willipe53/jolida/docs/Jolida-JD202A-int-sch.pdf

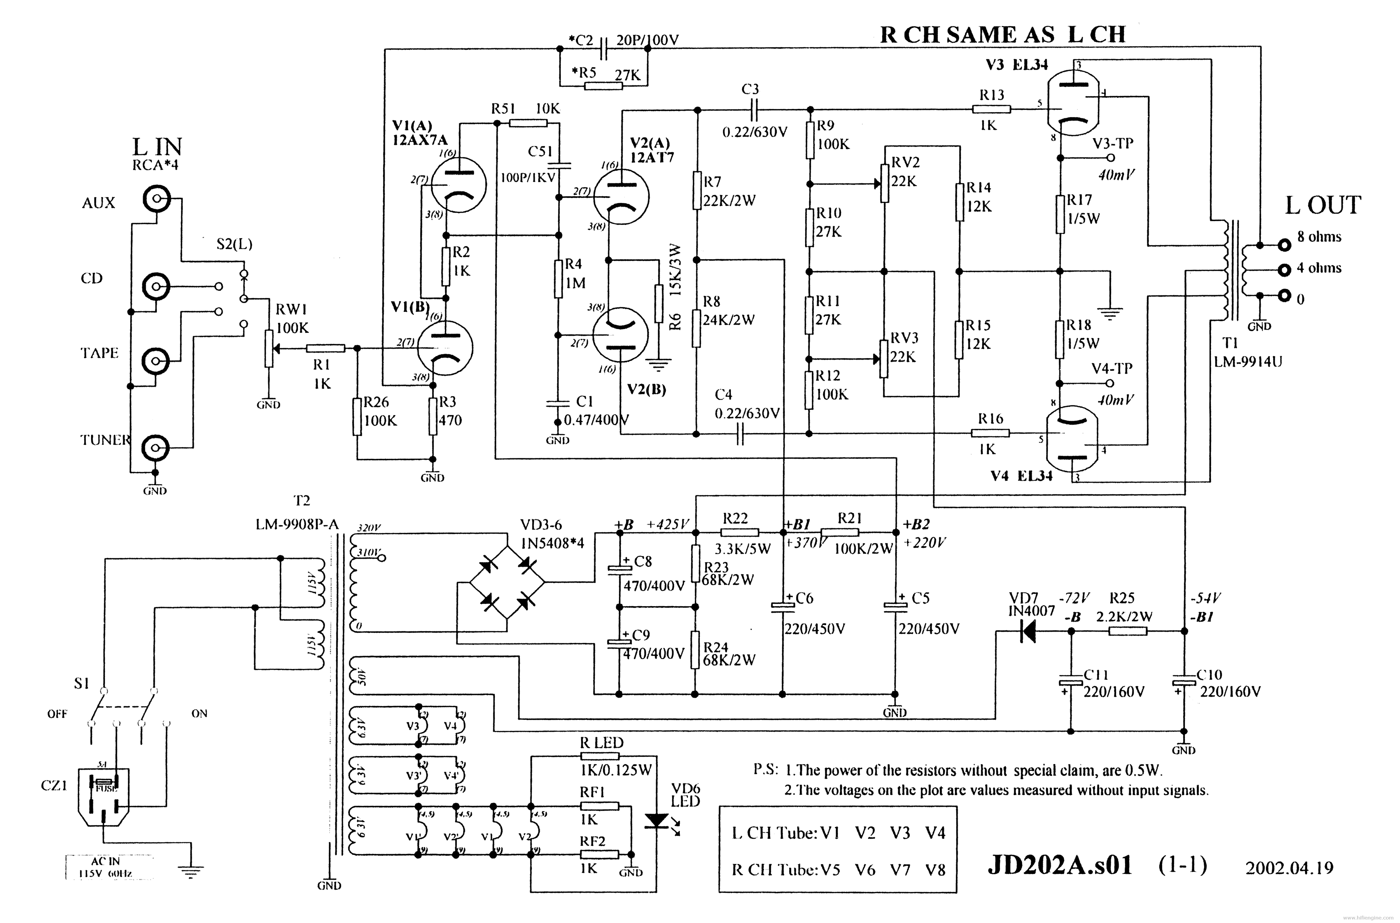
[picture p8: page 1]
