willipe53/jolida/docs/_sch-output.png

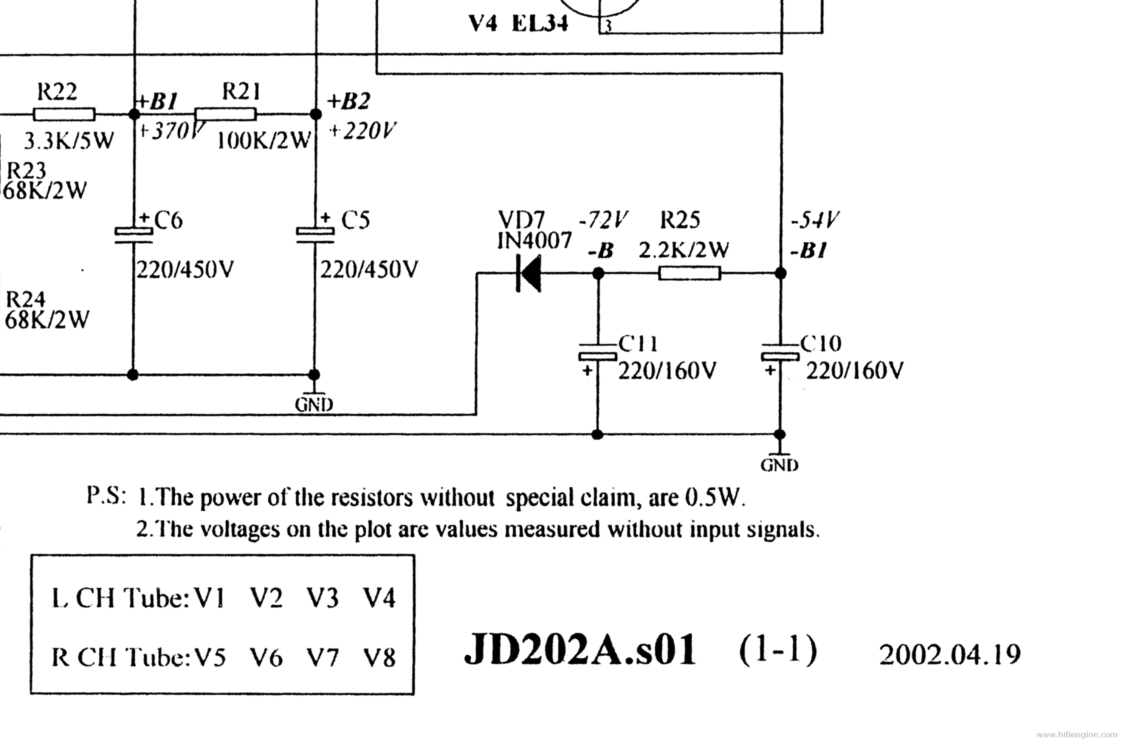
docs/_sch-output.png
