willipe53/jolida/docs/_sch-power.png

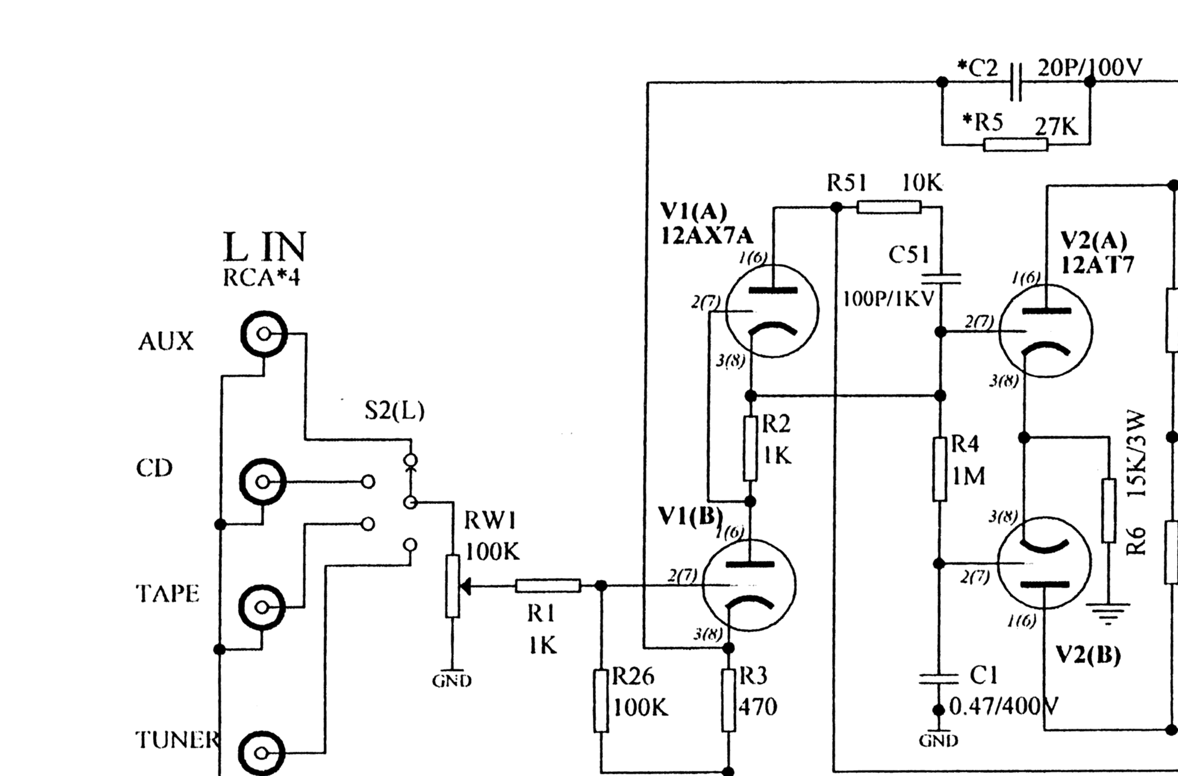
docs/_sch-power.png
