willipe53/jolida/docs/_sch-preamp.png

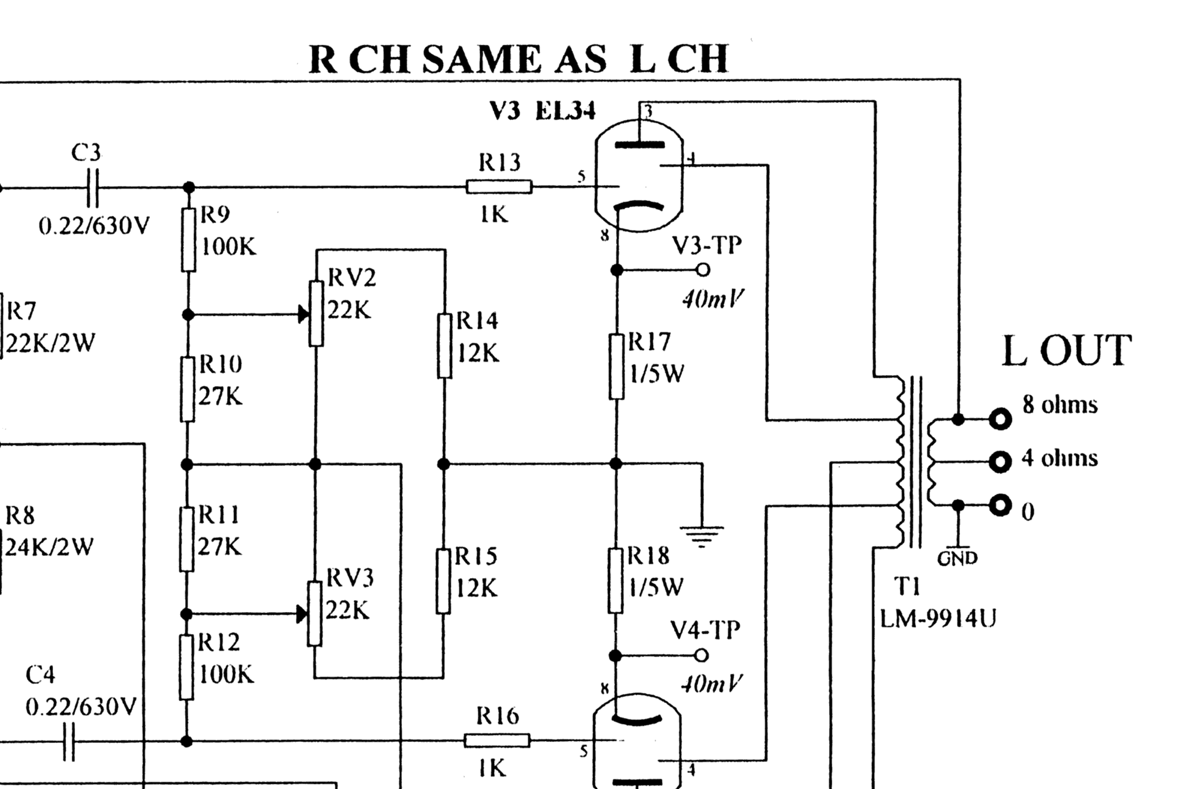
docs/_sch-preamp.png
