willipe53/jolida/docs/_sch-psu-detail.png

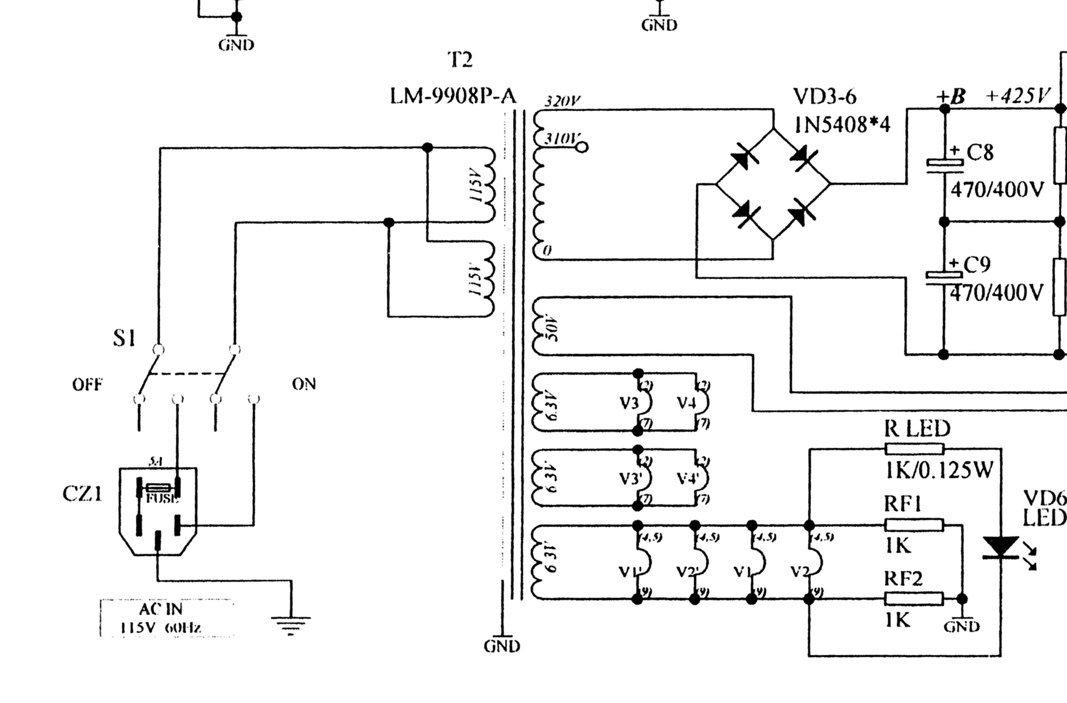
docs/_sch-psu-detail.png
