willipe53/jolida/docs/power-board.png

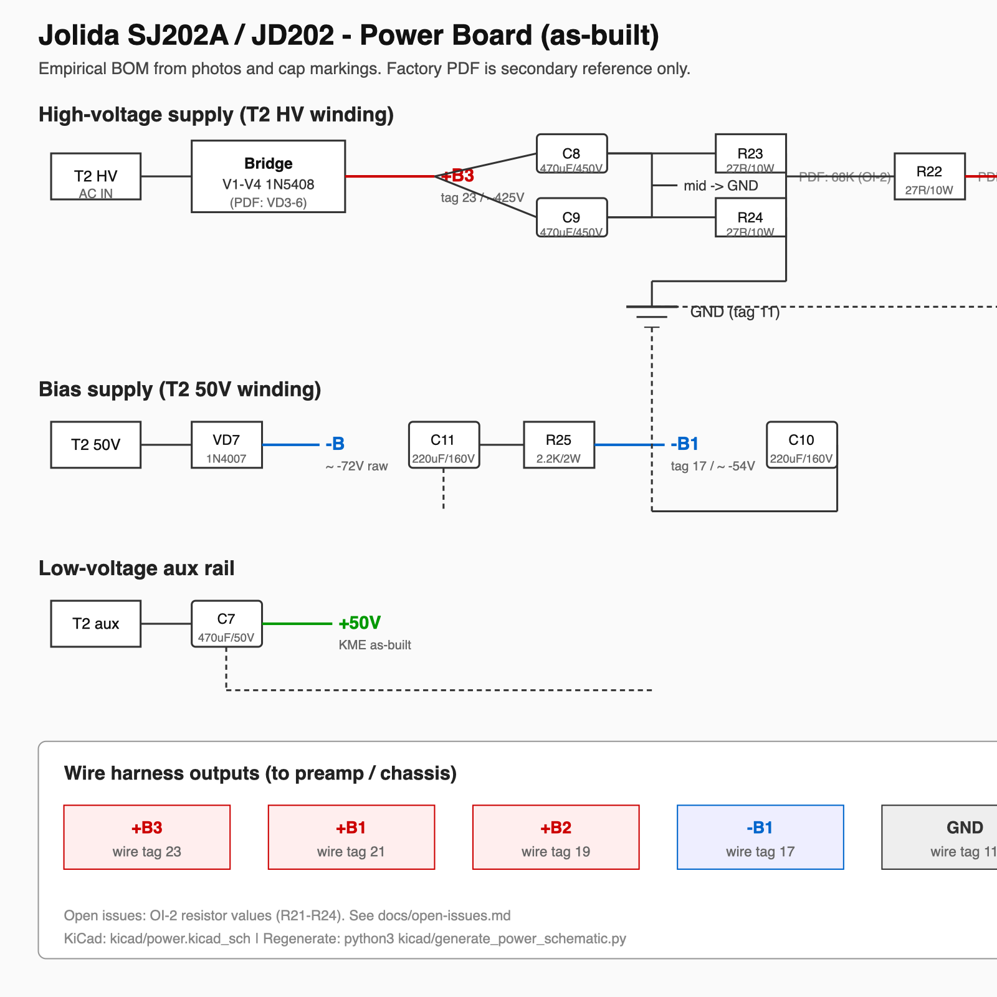
docs/power-board.png
