willipe53/jolida/photos/8 pin 1.png

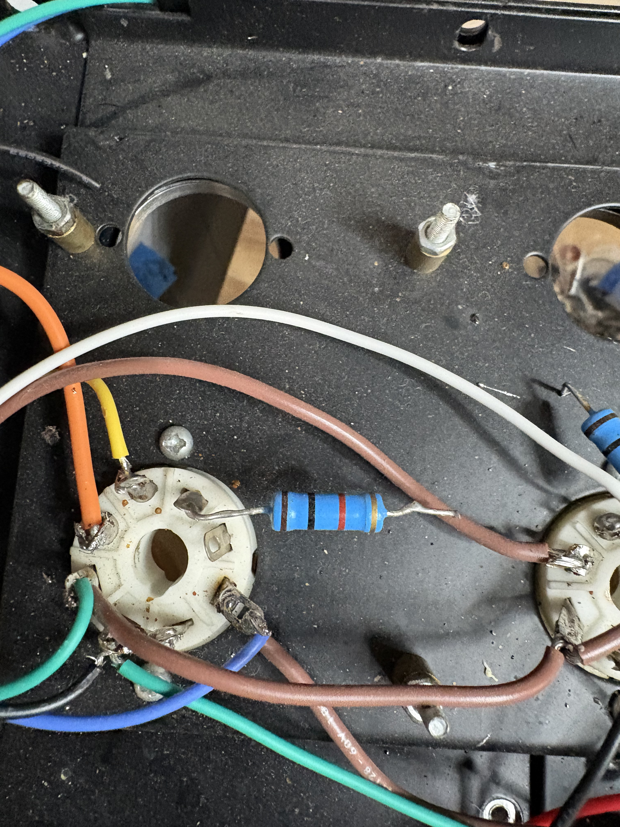
photos/8 pin 1.png
