willipe53/jolida/photos/8 pin 3.png

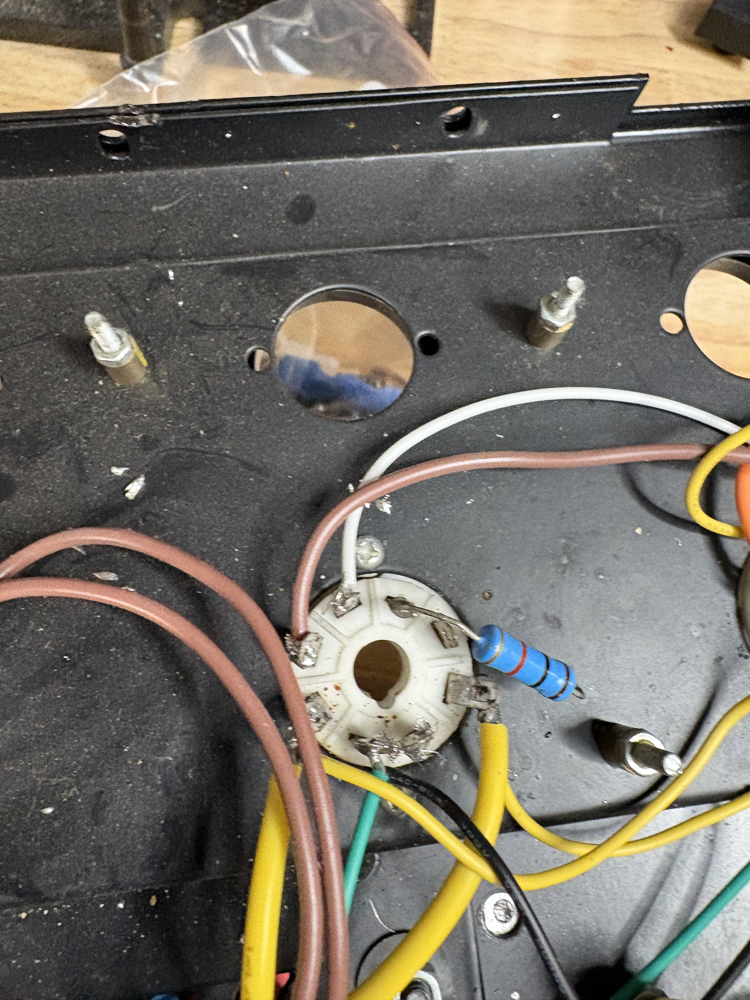
photos/8 pin 3.png
