willipe53/jolida/photos/8 pin 4.png

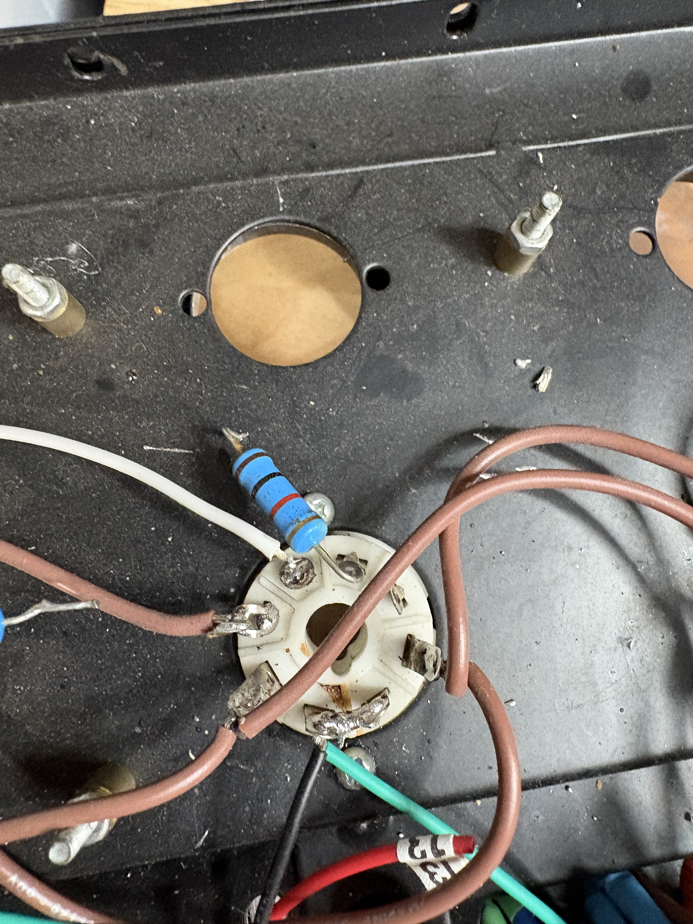
photos/8 pin 4.png
