willipe53/jolida/photos/8 pin 5.png

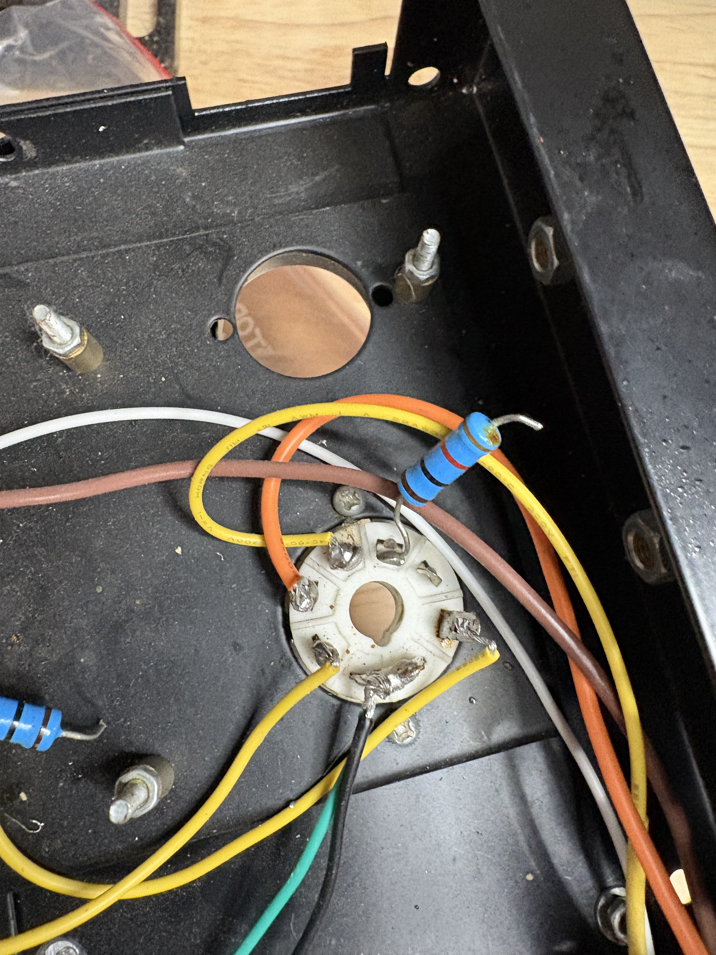
photos/8 pin 5.png
