willipe53/jolida/photos/feet.png

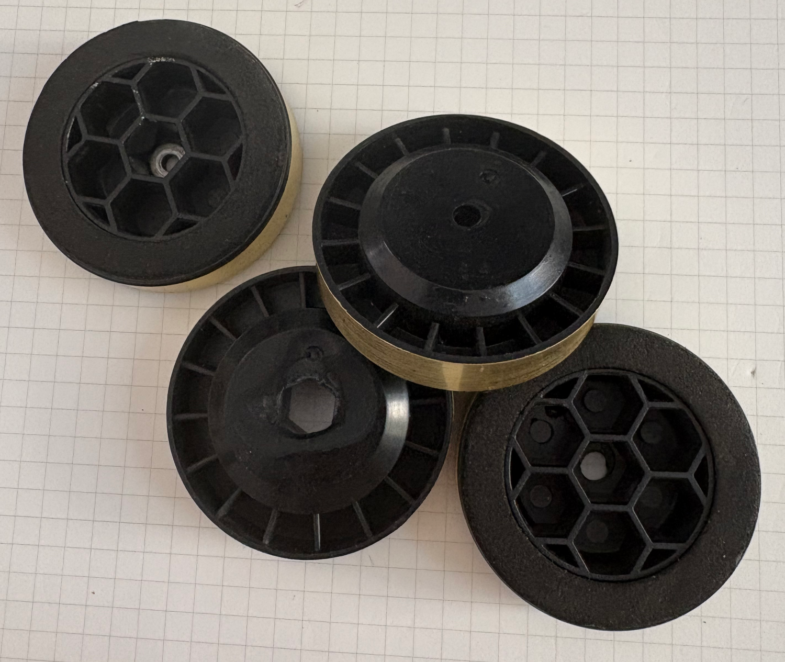
photos/feet.png
