willipe53/jolida/photos/fuse dry fit.png

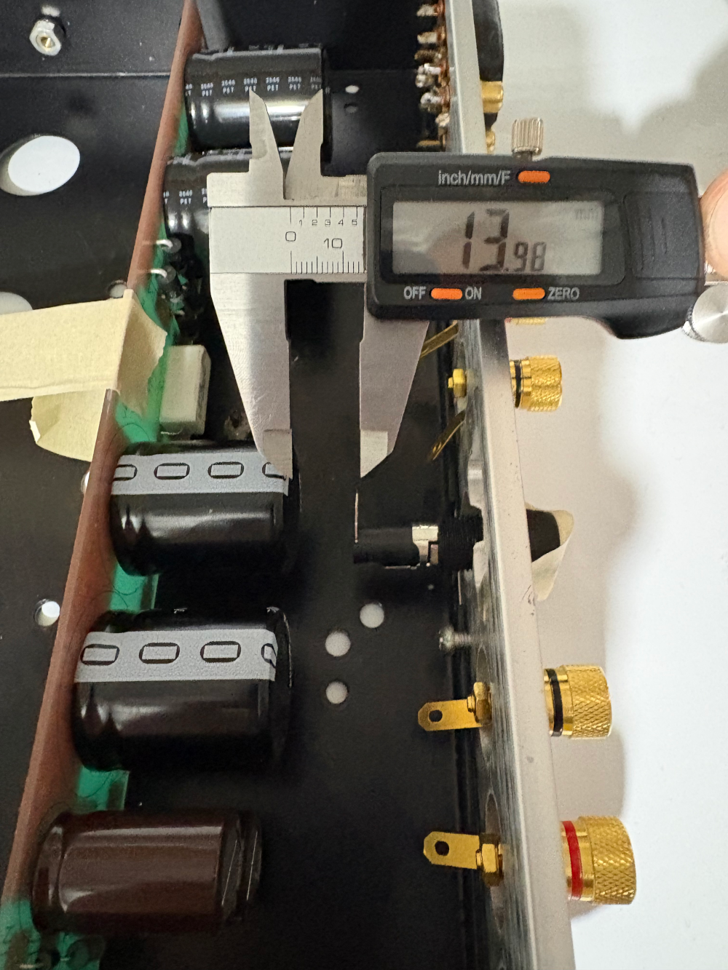
photos/fuse dry fit.png
