willipe53/jolida/photos/green caps.png

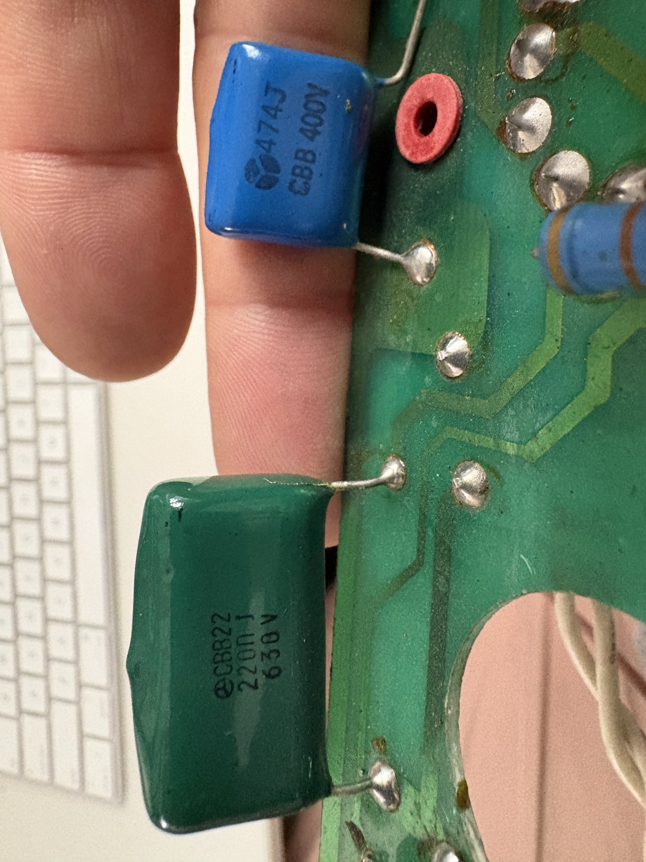
photos/green caps.png
