willipe53/jolida/photos/irl244n.png

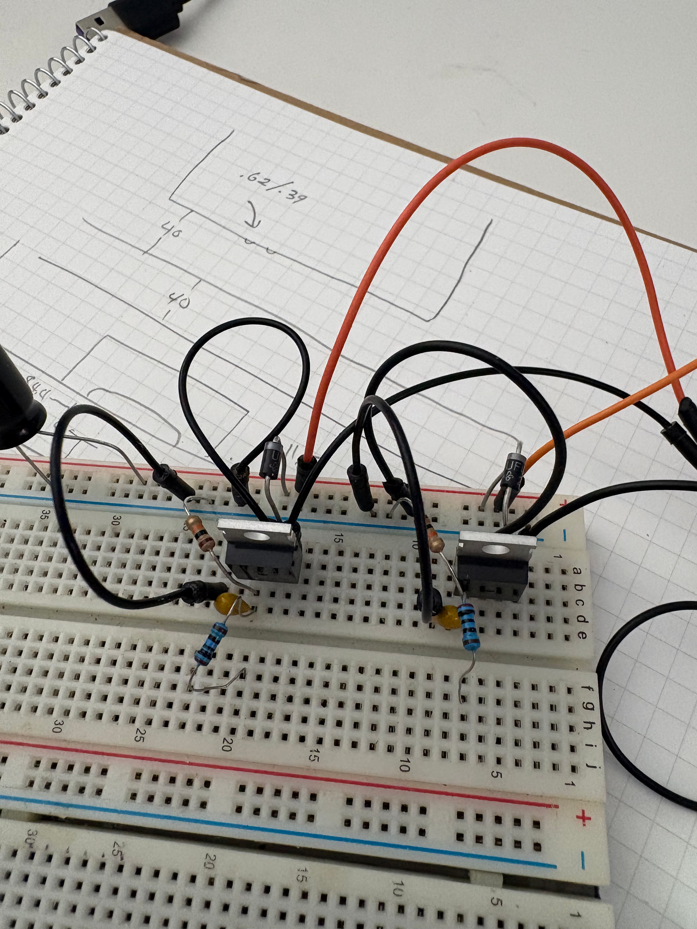
photos/irl244n.png
