willipe53/jolida/photos/LED wires.png

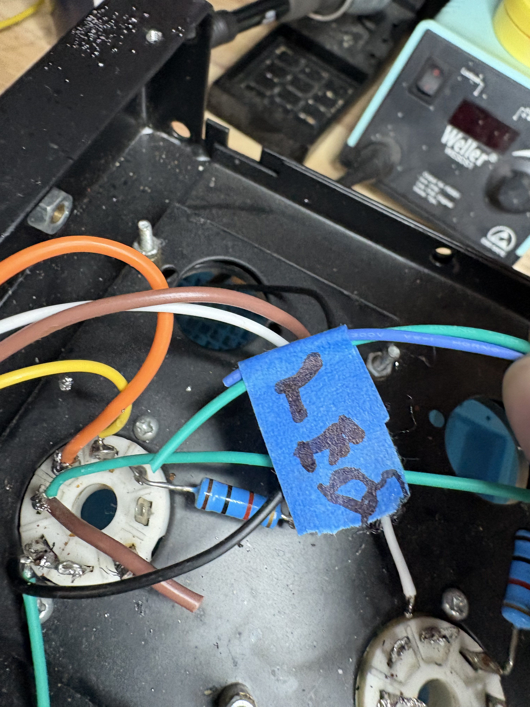
photos/LED wires.png
