willipe53/jolida/photos/preamp board top center.png

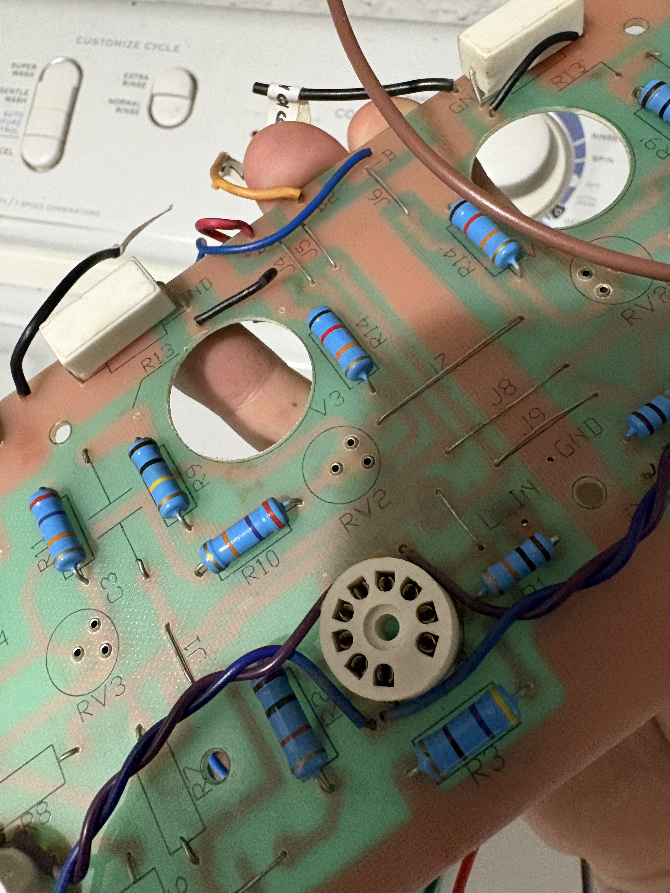
photos/preamp board top center.png
