willipe53/jolida/photos/speaker_posts.png

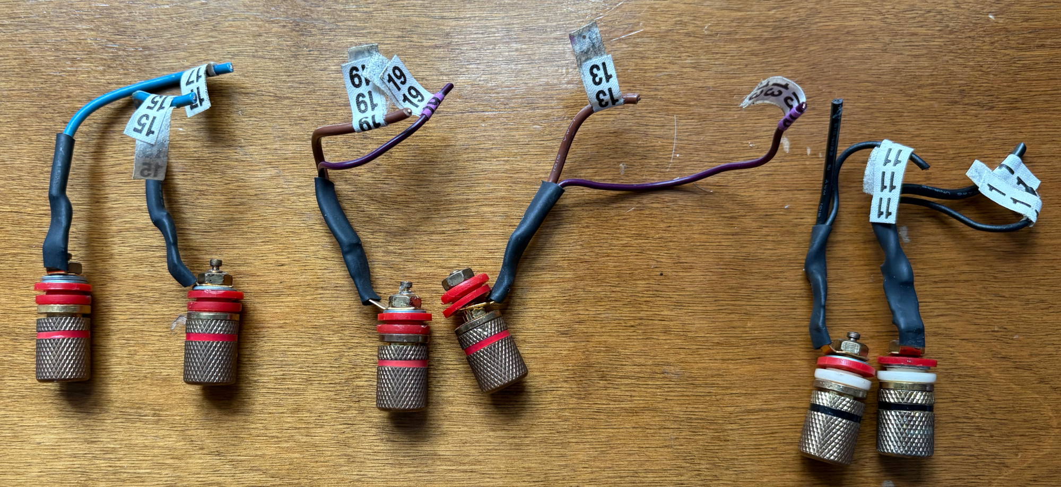
photos/speaker_posts.png
