willipe53/jolida/photos/trim pots.png

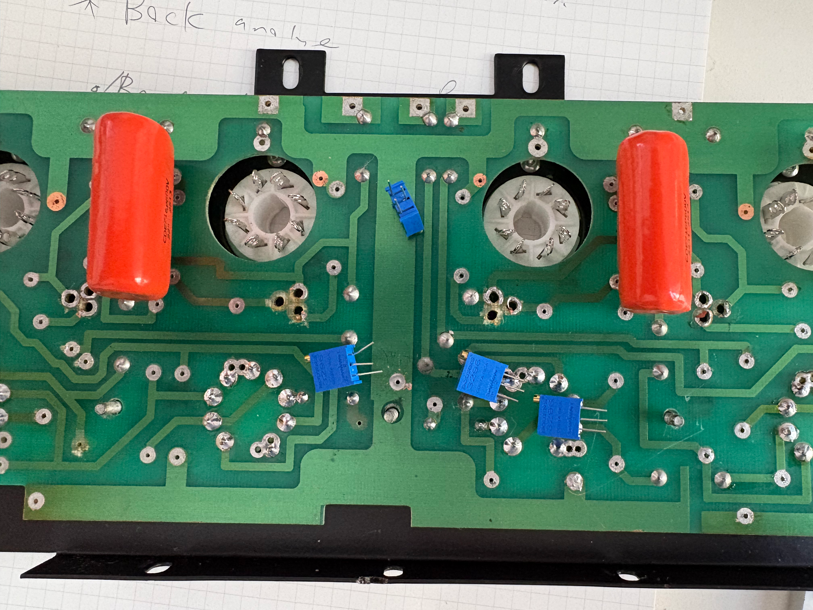
photos/trim pots.png
