willipe53/jolida/photos/tube layout.png

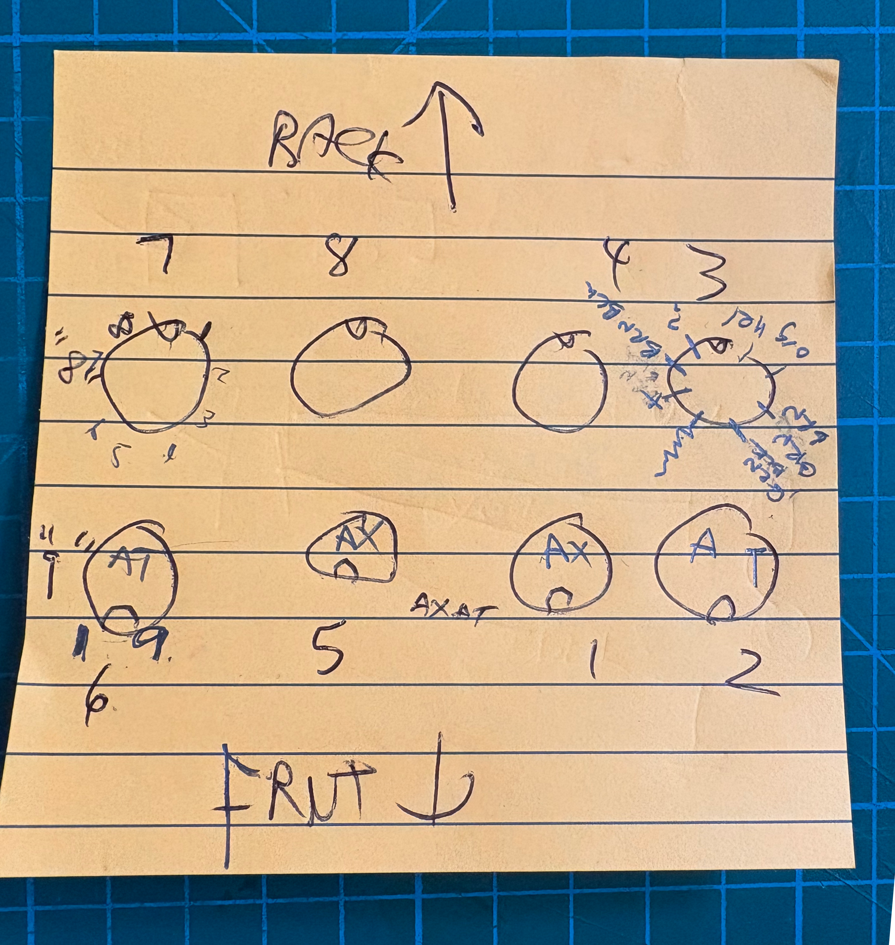
photos/tube layout.png
