willipe53/jolida/3d_printing/color_ring.3mf

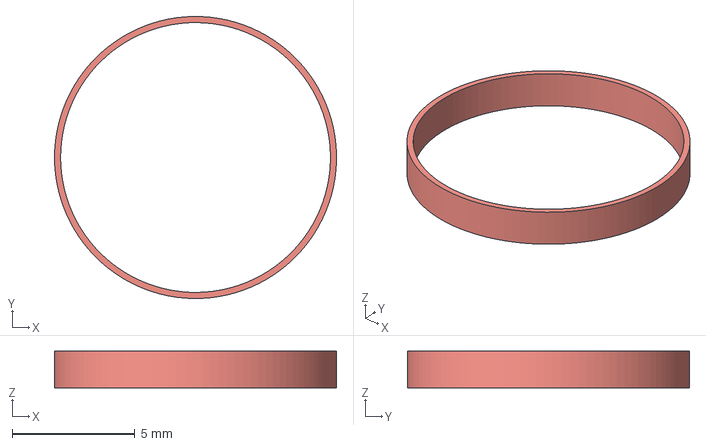
[picture p36: CAD file, 2026-07-29]
3d_printing/color_ring.3mf
11.5 x 11.5 x 1.50 mm
