willipe53/jolida/3d_printing/aux_only.3mf

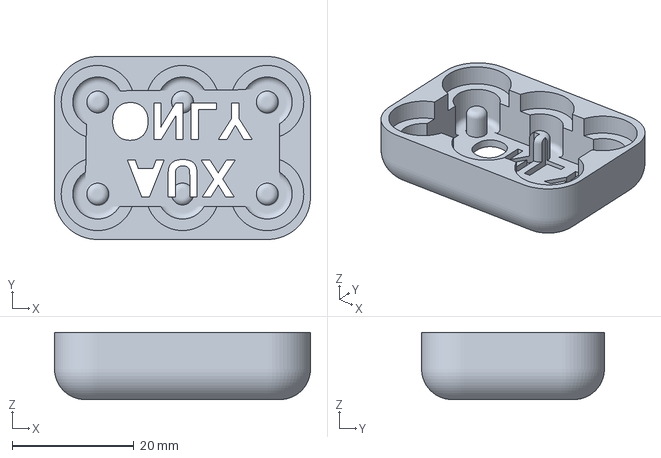
[picture p37: CAD file, 2026-07-29]
3d_printing/aux_only.3mf
42.0 x 30.0 x 11.0 mm
