willipe53/jolida/3d_printing/spkrspace.3mf

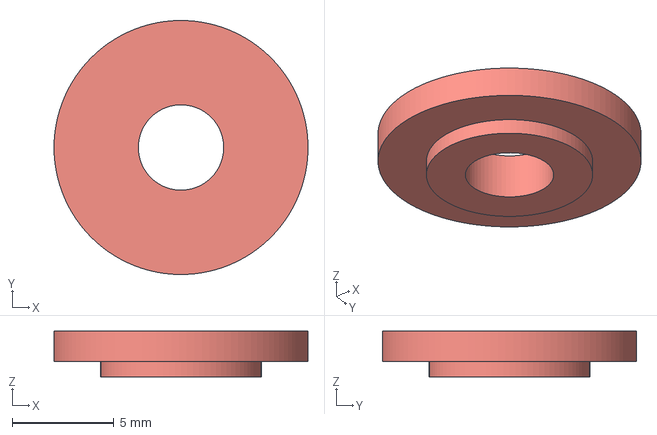
[picture p38: CAD file, 2026-07-29]
3d_printing/spkrspace.3mf
12.5 x 12.5 x 2.25 mm
