willipe53/jolida/photos/assembled amp.png

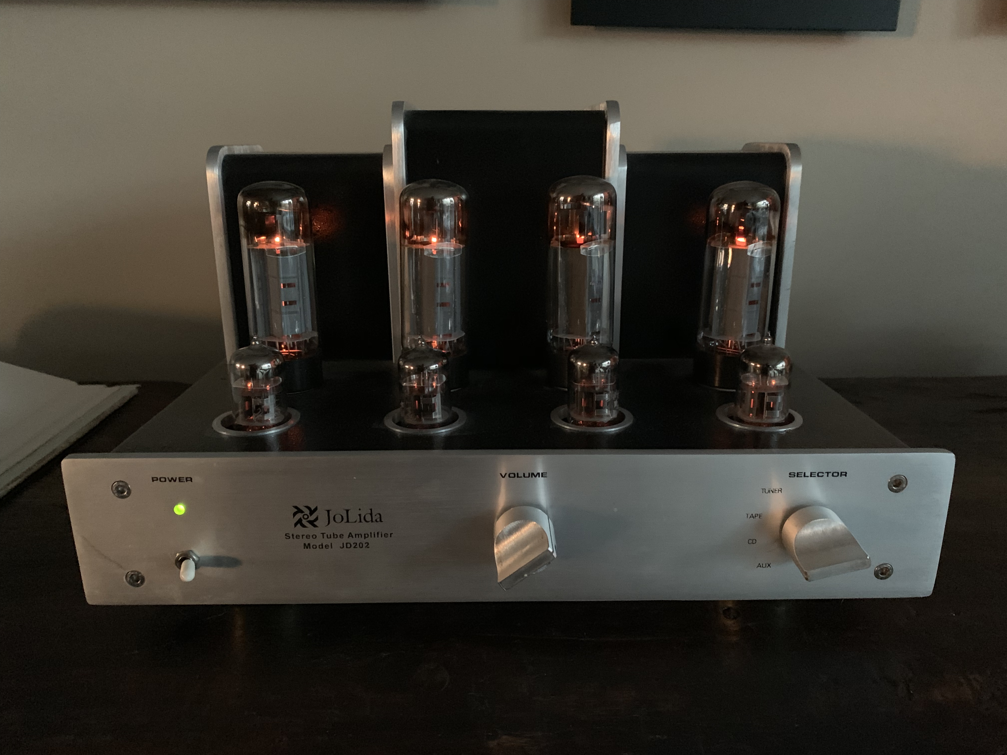
photos/assembled amp.png
