willipe53/jolida/photos/assembled bottom.png

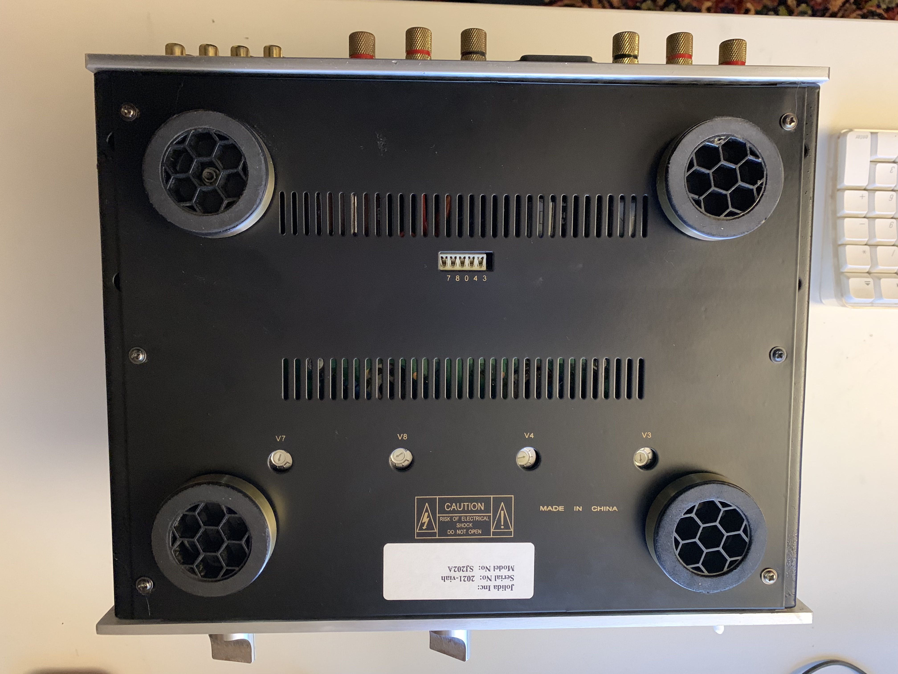
photos/assembled bottom.png
