willipe53/jolida/photos/preamp board bottom before desolder.png

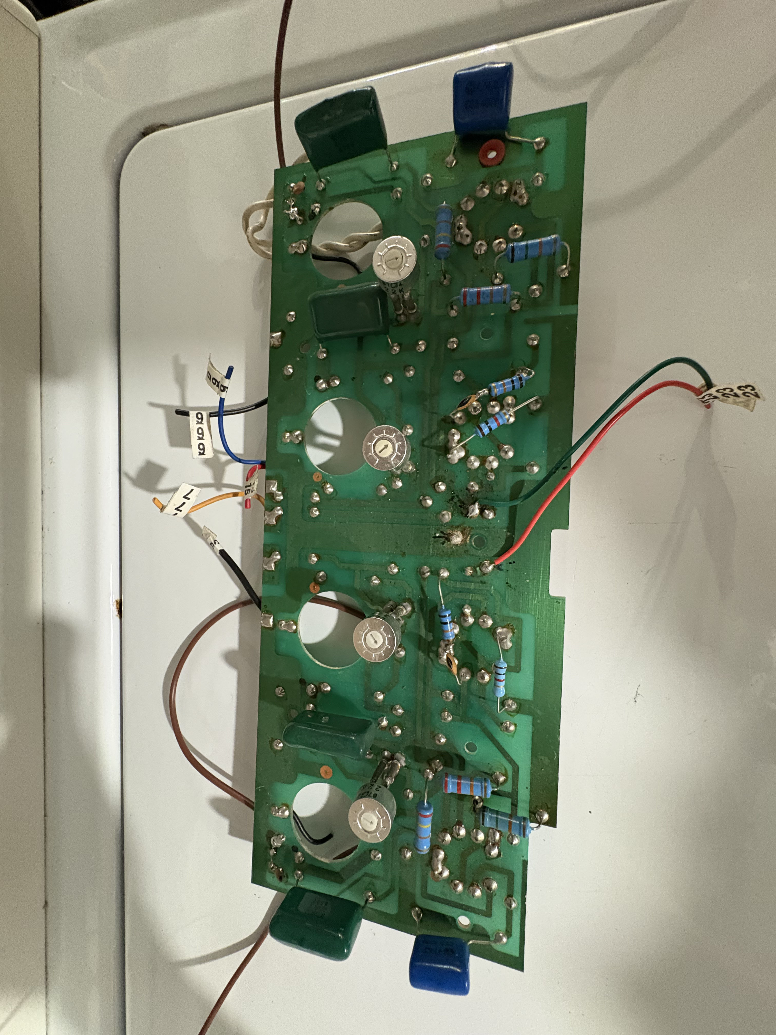
photos/preamp board bottom before desolder.png
