willipe53/jolida/photos/preamp board top center pre desolder.png

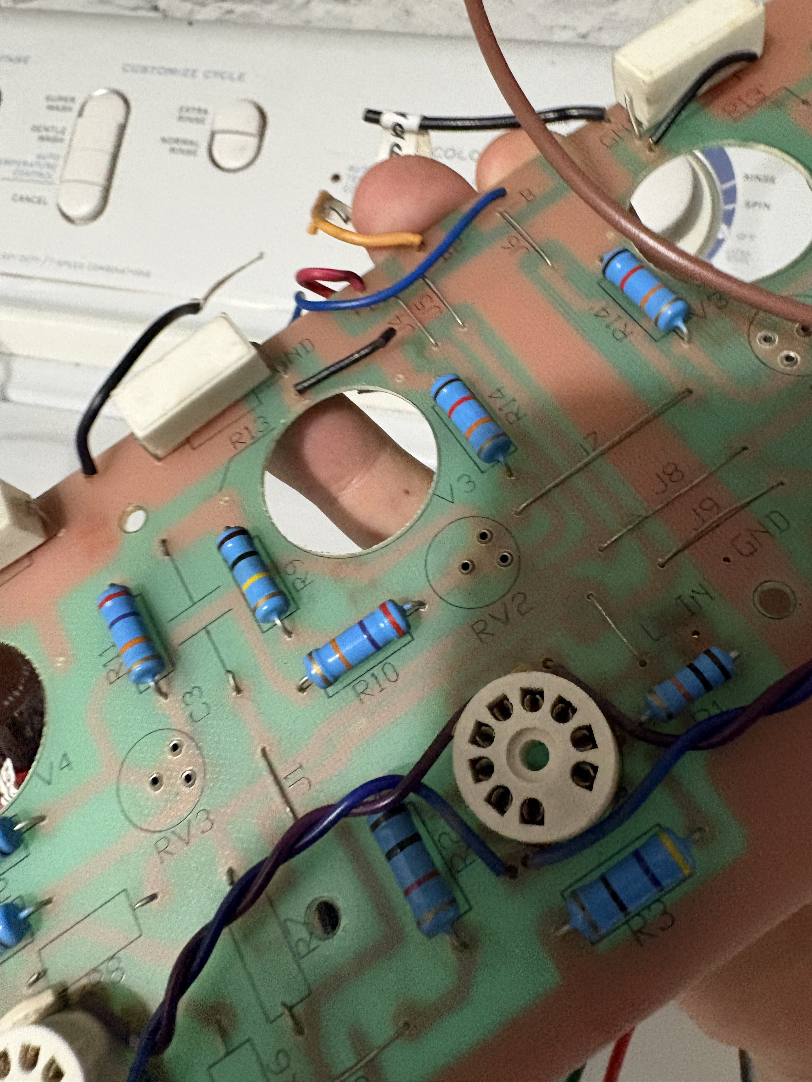
photos/preamp board top center pre desolder.png
