willipe53/jolida/(commit log)

2026-07-06 Initial pass closing open issues
    [jolida.kicad_pcb, jolida.kicad_sch, power.kicad_sch]
2026-07-29 Build nearly commplete.
    [aux_only.3mf, color_ring.3mf, jolida.kicad_pcb, jolida.kicad_sch, large-cap-board.kicad_sch, power.kicad_sch, spkrspace.3mf]
2026-07-29 deleted kidad
    [jolida.kicad_pcb, jolida.kicad_sch, large-cap-board.kicad_sch]
2026-07-31 Reororganized repo
    [aux_only.3mf, color_ring.3mf, spkrspace.3mf]
2026-10-06 First pass at solenoid controller
2026-10-10 Solenoid circuit
