willipe53/jolida/photos/board connects.png

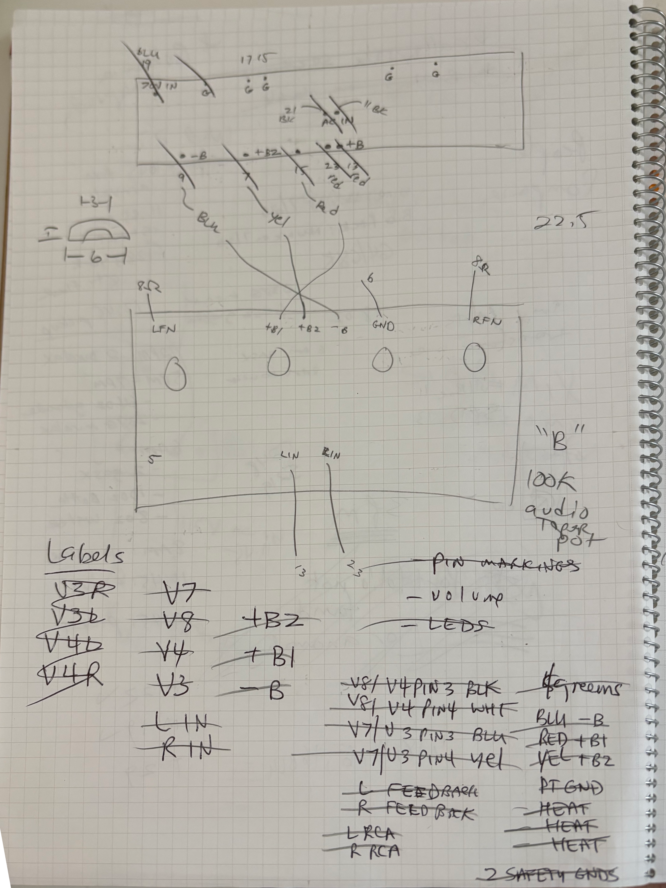
photos/board connects.png
