willipe53/jolida/photos/large cap board side.png

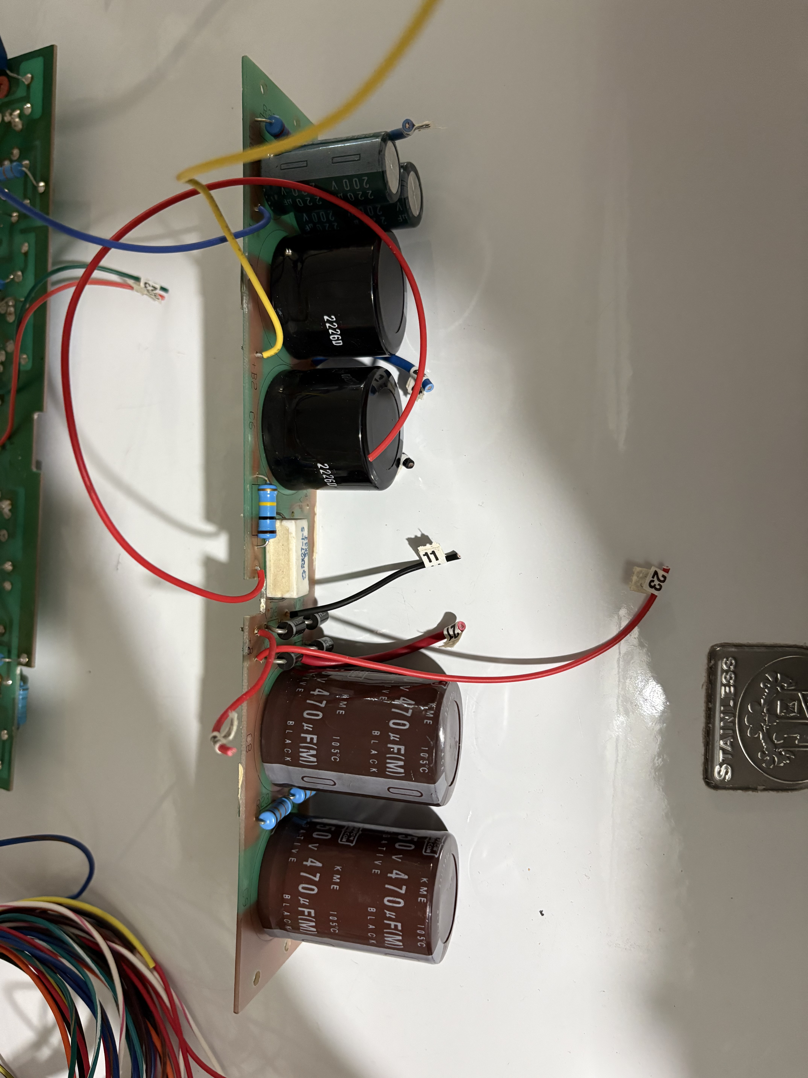
photos/large cap board side.png
