willipe53/jolida/photos/large cap board top 2.png

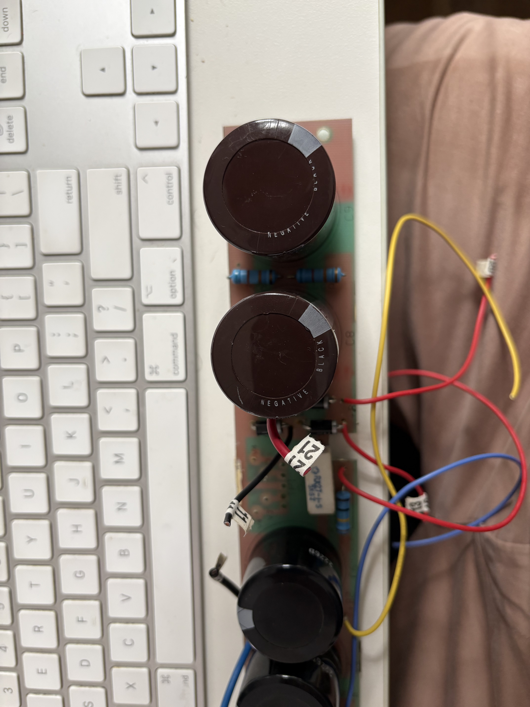
photos/large cap board top 2.png
