willipe53/jolida/photos/large cap board top.png

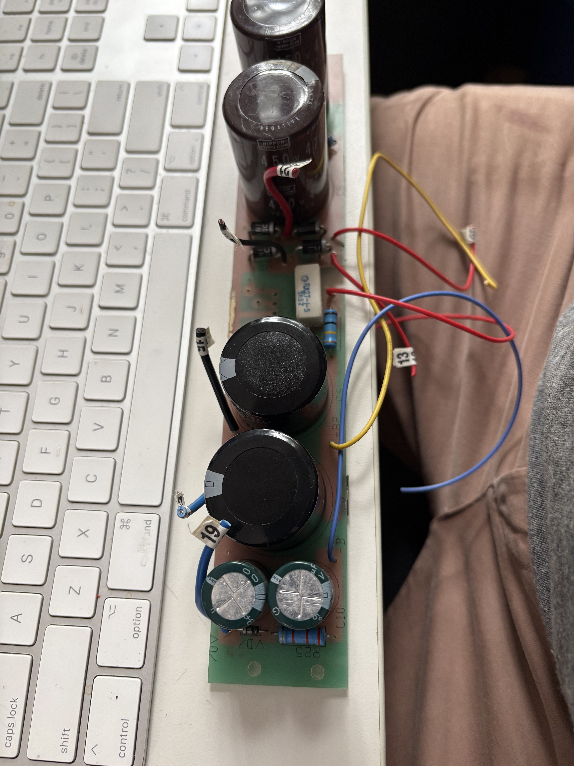
photos/large cap board top.png
