willipe53/jolida/photos/ot-1.png

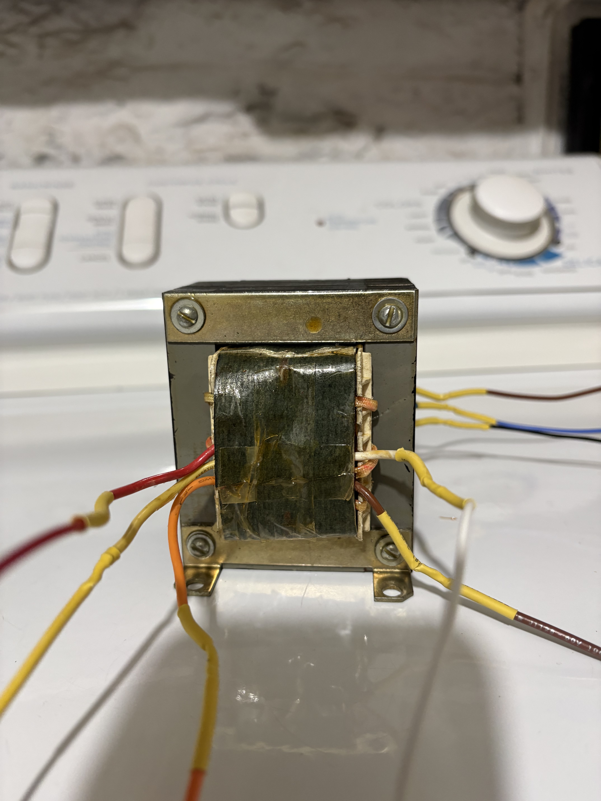
photos/ot-1.png
