willipe53/jolida/photos/ot-2.png

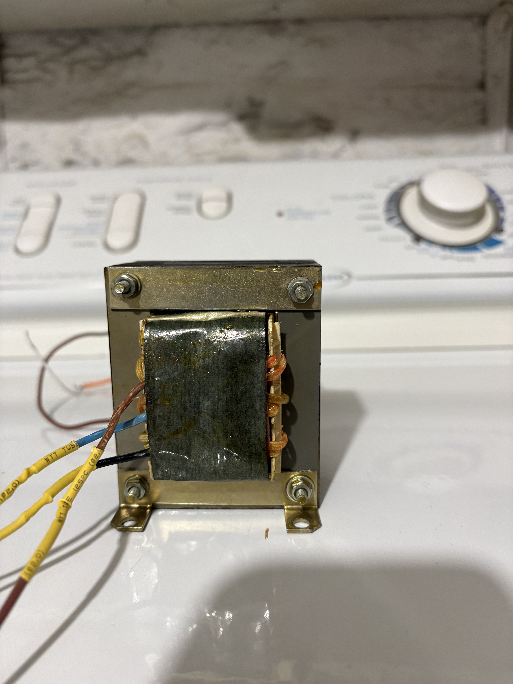
photos/ot-2.png
