willipe53/jolida/photos/ot-3.png

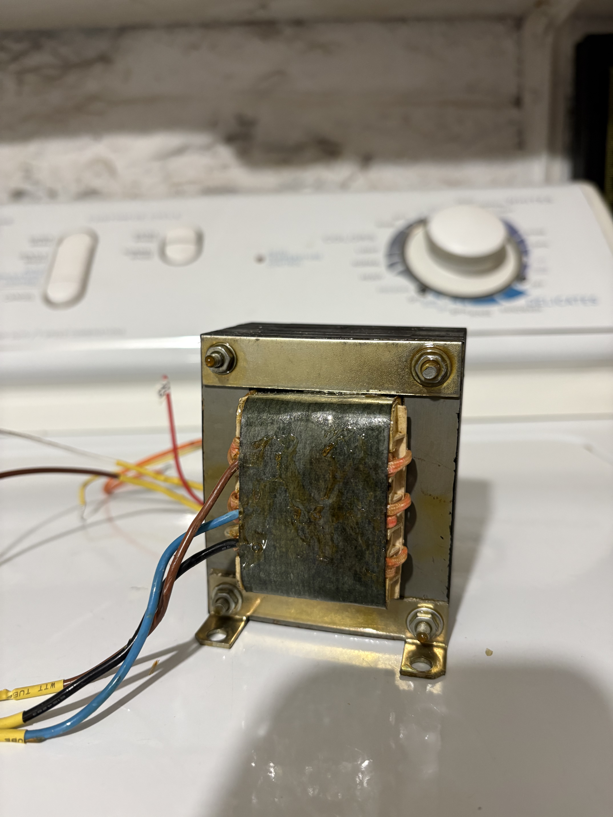
photos/ot-3.png
