willipe53/jolida/photos/ot-4.png

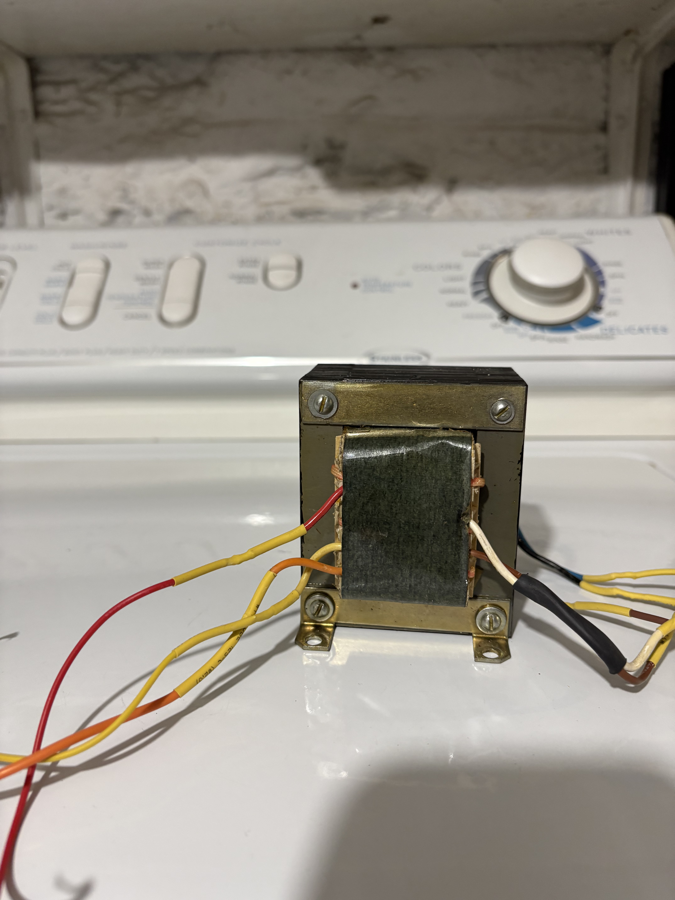
photos/ot-4.png
