willipe53/jolida/photos/solenoid_sketch.png

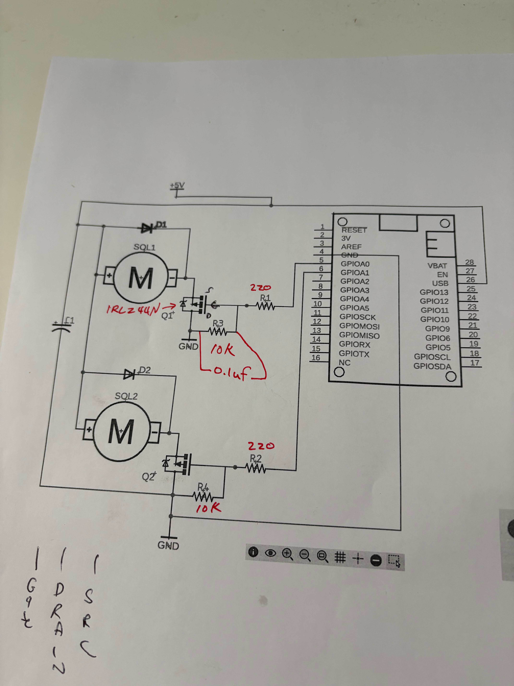
photos/solenoid_sketch.png
