willipe53/jolida/photos/assembly components.png

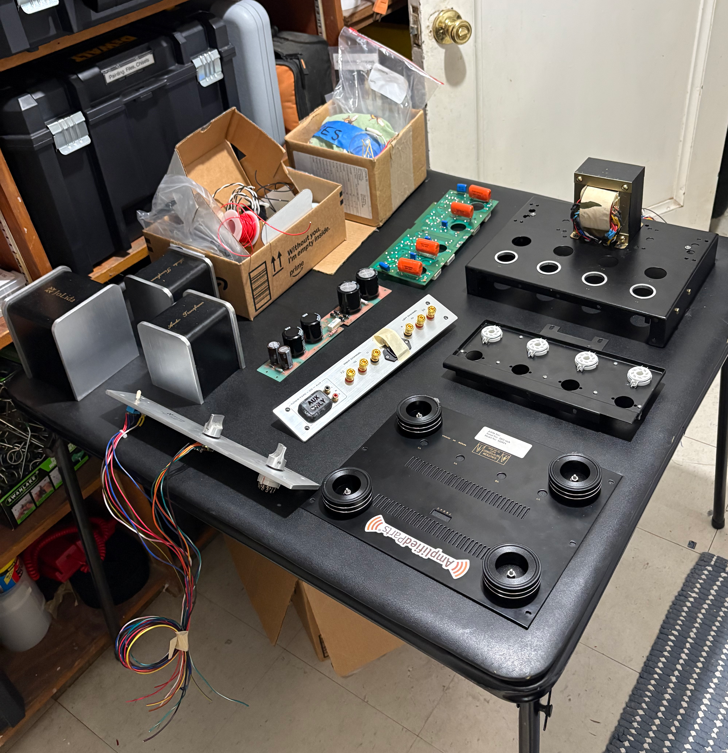
photos/assembly components.png
