willipe53/jolida/photos/assembly large cap board.png

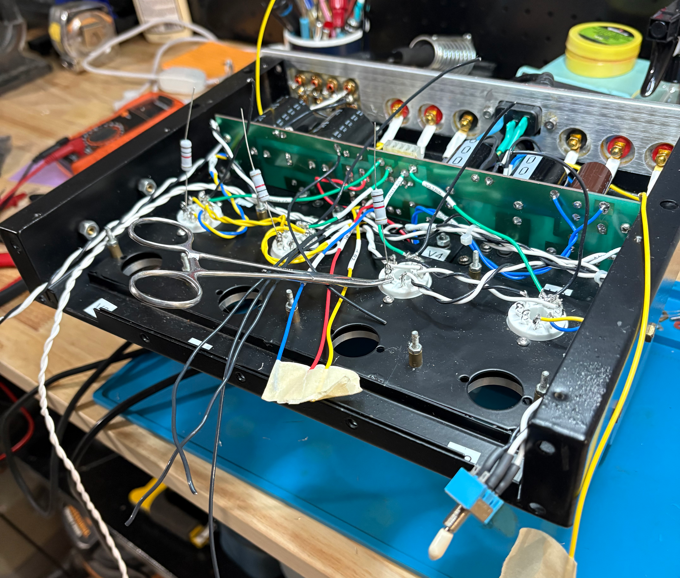
photos/assembly large cap board.png
