willipe53/jolida/photos/assembly transformer wires.png

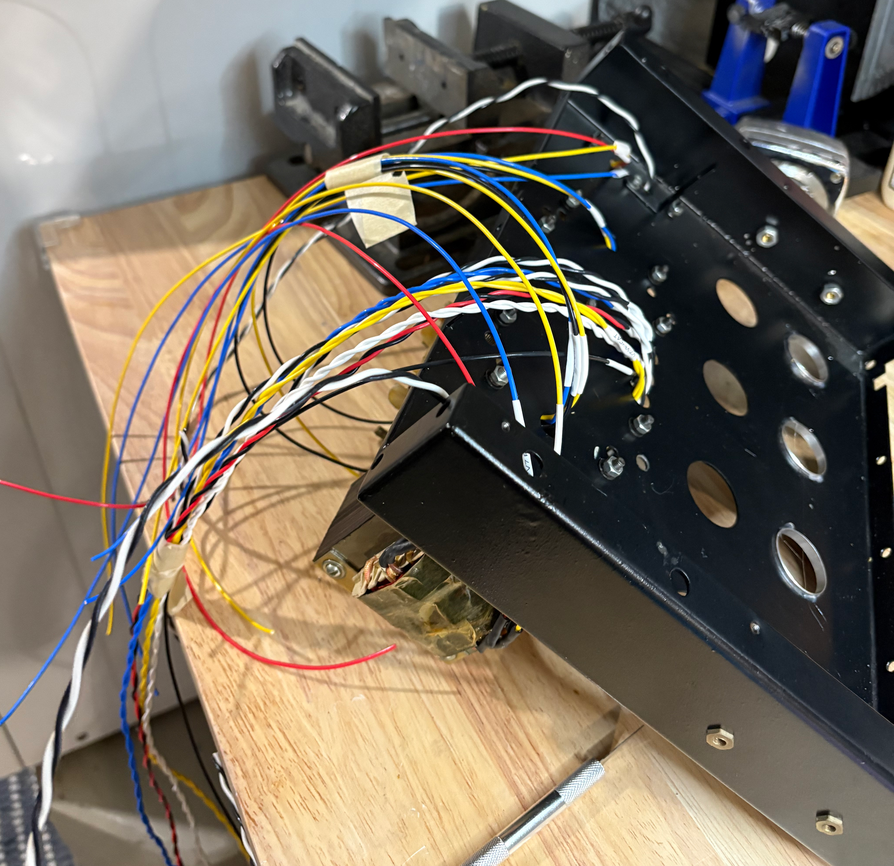
photos/assembly transformer wires.png
