willipe53/jolida/photos/preamp board top desoldered.png

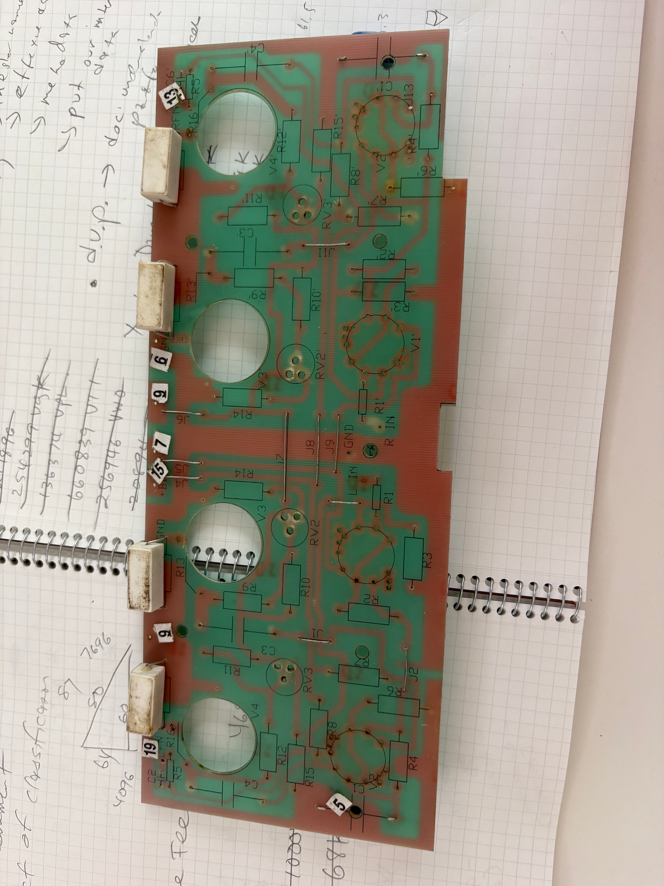
photos/preamp board top desoldered.png
