willipe53/jolida/photos/assembled from bottom.png

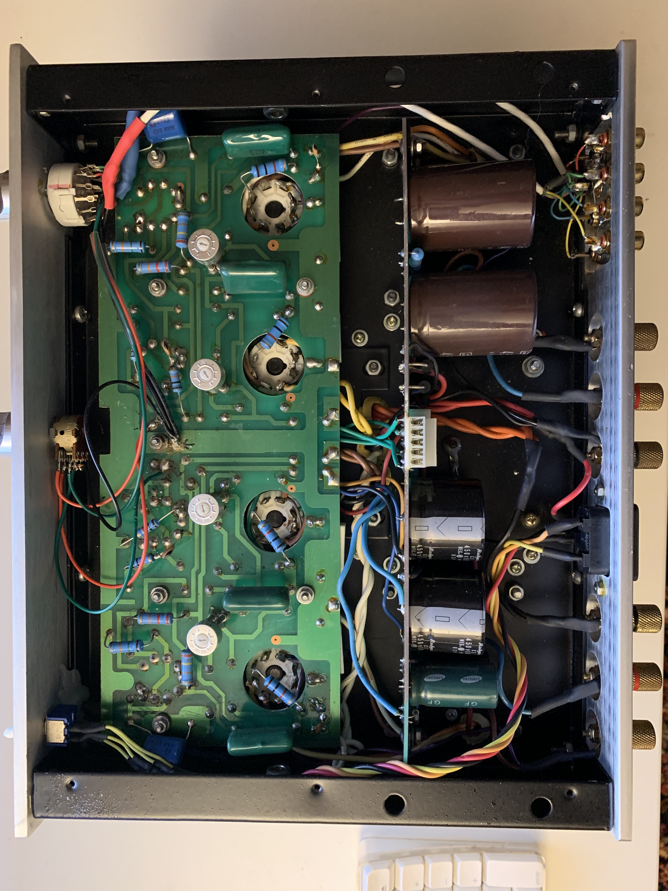
[picture p2: photos/assembled from bottom.png]
photos/assembled from bottom.png
