willipe53/jolida/photos/hand_schematic.png

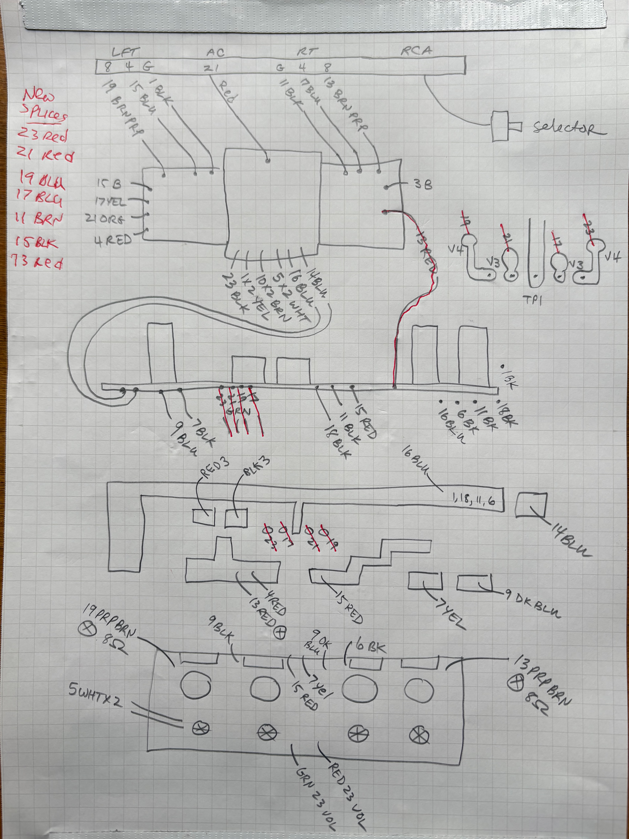
[picture p3: photos/hand_schematic.png]
photos/hand_schematic.png
