willipe53/jolida/photos/resistors.png

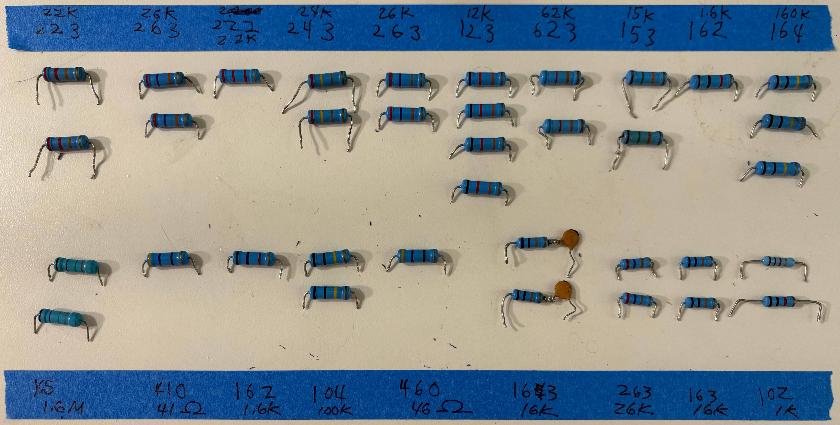
[picture p4: photos/resistors.png]
photos/resistors.png
